06Felix06/atmega_usbC_programmer/enclosure/stl/reset_button_cap.stl

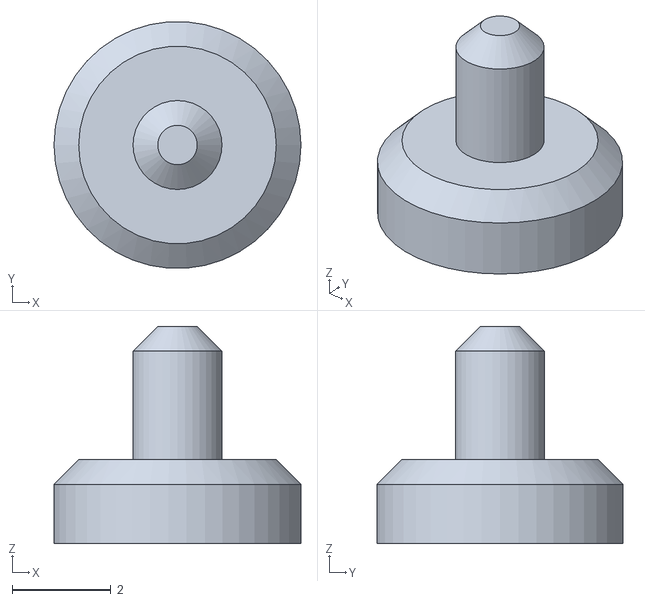
[picture p9: CAD file, 2026-11-07]
enclosure/stl/reset_button_cap.stl
5.00 x 4.99 x 4.40
