06Felix06/atmega_usbC_programmer/enclosure/stl/case_bottom.stl

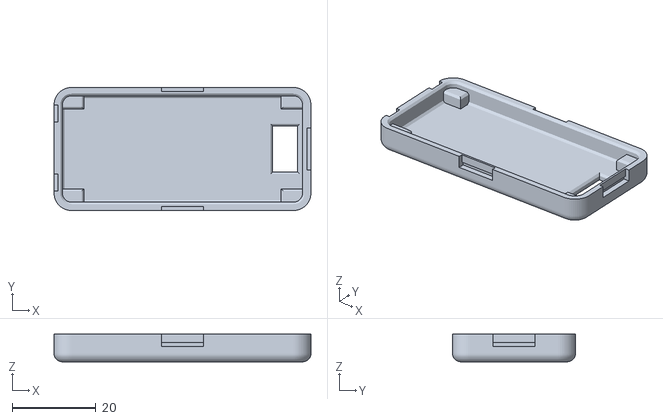
[picture p10: CAD file, 2026-11-07]
enclosure/stl/case_bottom.stl
61.4 x 29.4 x 6.60
