06Felix06/atmega_usbC_programmer/enclosure/stl/case_lid.stl

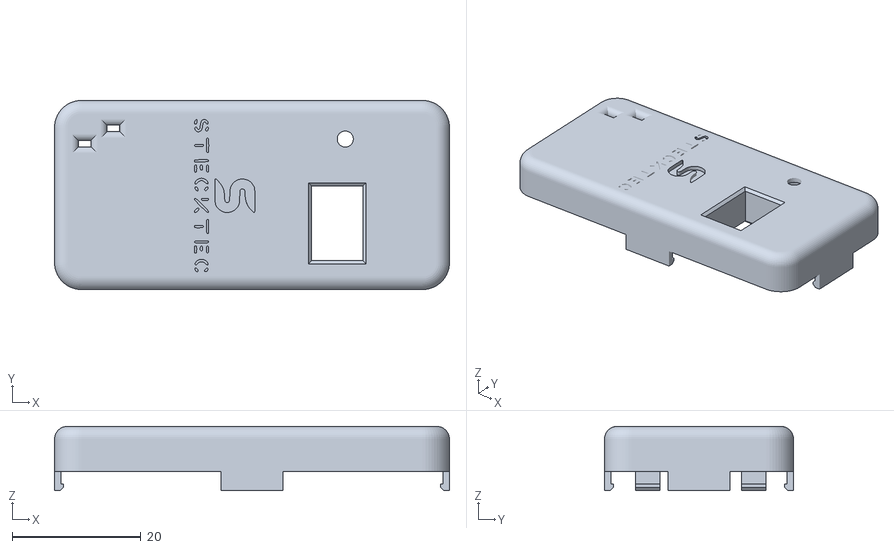
[picture p11: CAD file, 2026-11-07]
enclosure/stl/case_lid.stl
61.4 x 29.4 x 10.0
