06Felix06/atmega_usbC_programmer/(list of files, cad)

Other CAD files:
enclosure/fusion/ATmega_Programmer_Case.f3d
