06Felix06/atmega_usbC_programmer/hardware/Atmega_Programmer_Schematic.pdf

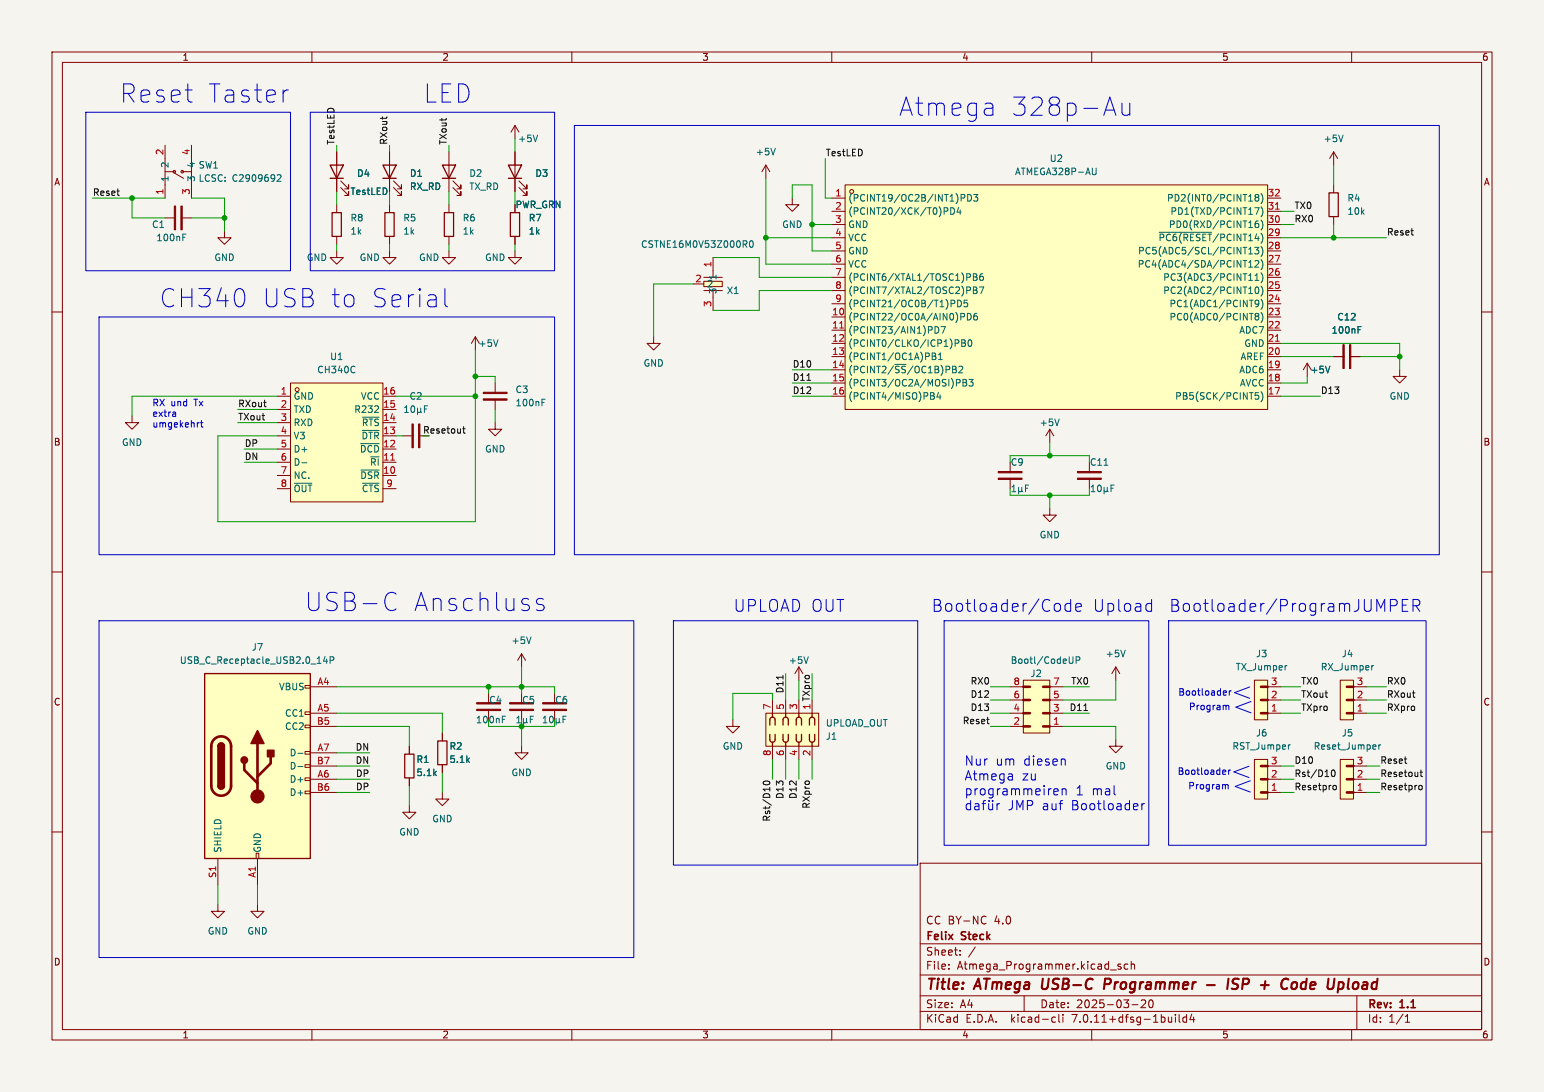
[picture p12: page 1]

RX und Tx extra

Nur um diesen
Atmega zu
þÿdafür JMP auf Bootloader

File: Atmega_Programmer.kicad_sch Sheet: / Felix Steck CC BY-NC 4.0 GND

Id: 1/1 Title: ATmega USB-C Programmer - ISP + Code Upload
